GuEMM/ArduMagnetometer/README.md

## Project: Iniciación Científica - Departamento de Física
**Facultad de Ciencias Exactas y Naturales - Universidad Nacional de Asunción**

# ArduMagnetometer
This project contain the software for an arduino based low cost geomagnetometer using FG3 fluxgate sensors.
