GuEMM/ArduMagnetometer/Codigo_para_analisis_calibracion/Datos_corriente_FG3_s1_Curva1.csv

2 | 19692016 | 8727070 | -0.0815 | 0.00005 | Wed Jul 31 16:58:47 2019
3 | 19662588 | 8714294 | -0.0815 | 0.00005 | Wed Jul 31 16:58:48 2019
4 | 19663364 | 8714294 | -0.0815 | 0.00005 | Wed Jul 31 16:58:49 2019
5 | 19663364 | 8714142 | -0.0815 | 0.00005 | Wed Jul 31 16:58:50 2019
6 | 19662588 | 8714142 | -0.0815 | 0.00005 | Wed Jul 31 16:58:51 2019
7 | 19661044 | 8713990 | -0.0815 | 0.00005 | Wed Jul 31 16:58:52 2019
8 | 19663364 | 8714446 | -0.0815 | 0.00005 | Wed Jul 31 16:58:53 2019
9 | 19664136 | 8713990 | -0.0815 | 0.00005 | Wed Jul 31 16:58:54 2019
10 | 19662588 | 8713686 | -0.0815 | 0.00005 | Wed Jul 31 16:58:55 2019
11 | 19661044 | 8711864 | -0.0815 | 0.00005 | Wed Jul 31 16:58:56 2019
12 | 19661044 | 8711864 | -0.0815 | 0.00005 | Wed Jul 31 16:58:57 2019
13 | 19661044 | 8713382 | -0.0815 | 0.00005 | Wed Jul 31 16:58:58 2019
14 | 19659496 | 8713382 | -0.0815 | 0.00005 | Wed Jul 31 16:58:59 2019
15 | 19659496 | 8713078 | -0.0815 | 0.00005 | Wed Jul 31 16:59:00 2019
16 | 19659496 | 8713078 | -0.0815 | 0.00005 | Wed Jul 31 16:59:01 2019
17 | 19660270 | 8712320 | -0.0815 | 0.00005 | Wed Jul 31 16:59:02 2019
18 | 19659496 | 8712926 | -0.0815 | 0.00005 | Wed Jul 31 16:59:03 2019
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
