GuEMM/ArduMagnetometer/Codigo_para_analisis_calibracion/Datos_corriente_FG3_s2_Curva2.csv

234 | 18664376 | 8277597 | -0.0805 | 0.00005 | Tue Jul 30 13:27:02 2019
235 | 18664376 | 8277871 | -0.0805 | 0.00005 | Tue Jul 30 13:27:03 2019
236 | 18664376 | 8278008 | -0.0805 | 0.00005 | Tue Jul 30 13:27:04 2019
237 | 18662984 | 8277734 | -0.0805 | 0.00005 | Tue Jul 30 13:27:05 2019
238 | 18662984 | 8277460 | -0.0805 | 0.00005 | Tue Jul 30 13:27:06 2019
239 | 18664376 | 8277323 | -0.0805 | 0.00005 | Tue Jul 30 13:27:07 2019
240 | 18664376 | 8276364 | -0.0805 | 0.00005 | Tue Jul 30 13:27:08 2019
241 | 18665072 | 8276227 | -0.0805 | 0.00005 | Tue Jul 30 13:27:09 2019
242 | 18665072 | 8276227 | -0.0805 | 0.00005 | Tue Jul 30 13:27:10 2019
243 | 18665072 | 8276227 | -0.0805 | 0.00005 | Tue Jul 30 13:27:11 2019
244 | 18663680 | 8276227 | -0.0805 | 0.00005 | Tue Jul 30 13:27:12 2019
245 | 18663680 | 8276638 | -0.0805 | 0.00005 | Tue Jul 30 13:27:13 2019
246 | 18663680 | 8276775 | -0.0805 | 0.00005 | Tue Jul 30 13:27:14 2019
247 | 18663680 | 8277049 | -0.0805 | 0.00005 | Tue Jul 30 13:27:15 2019
248 | 18663680 | 8277049 | -0.0805 | 0.00005 | Tue Jul 30 13:27:16 2019
249 | 18663680 | 8277186 | -0.0805 | 0.00005 | Tue Jul 30 13:27:17 2019
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
