GuEMM/ArduMagnetometer/Codigo_para_analisis_calibracion/Datos_corriente_FG3_s2_Curva3.csv

3 | 18991908 | 8253140 | -0.0796 | 0.00005 | Wed Jul 31 12:56:58 2019
4 | 18989024 | 8252731 | -0.0796 | 0.00005 | Wed Jul 31 12:56:59 2019
5 | 18989744 | 8252459 | -0.0796 | 0.00005 | Wed Jul 31 12:57:00 2019
6 | 18989744 | 8252323 | -0.0796 | 0.00005 | Wed Jul 31 12:57:01 2019
7 | 18988304 | 8252595 | -0.0796 | 0.00005 | Wed Jul 31 12:57:02 2019
8 | 18989744 | 8252595 | -0.0796 | 0.00005 | Wed Jul 31 12:57:03 2019
9 | 18990466 | 8253004 | -0.0796 | 0.00005 | Wed Jul 31 12:57:04 2019
10 | 18991188 | 8252867 | -0.0796 | 0.00005 | Wed Jul 31 12:57:05 2019
11 | 18987582 | 8251642 | -0.0796 | 0.00005 | Wed Jul 31 12:57:06 2019
12 | 18986860 | 8250825 | -0.0796 | 0.00005 | Wed Jul 31 12:57:07 2019
13 | 18986140 | 8250280 | -0.0796 | 0.00005 | Wed Jul 31 12:57:08 2019
14 | 18985420 | 8250280 | -0.0796 | 0.00005 | Wed Jul 31 12:57:09 2019
15 | 18983976 | 8250008 | -0.0796 | 0.00005 | Wed Jul 31 12:57:10 2019
16 | 18983976 | 8251097 | -0.0796 | 0.00005 | Wed Jul 31 12:57:11 2019
17 | 18983976 | 8251914 | -0.0796 | 0.00005 | Wed Jul 31 12:57:12 2019
18 | 18986140 | 8251369 | -0.0796 | 0.00005 | Wed Jul 31 12:57:13 2019
19 | 18984698 | 8251914 | -0.0796 | 0.00005 | Wed Jul 31 12:57:14 2019
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
