GuEMM/ArduMagnetometer/Codigo_para_analisis_calibracion/Datos_corriente_FG3_s4_Curva1.csv

2 | 18574932 | 26406126 | 0.0808 | 0.00005 | Fri Aug 2 14:32:01 2019
3 | 18555628 | 26379656 | 0.0808 | 0.00005 | Fri Aug 2 14:32:02 2019
4 | 18556318 | 26379656 | 0.0808 | 0.00005 | Fri Aug 2 14:32:03 2019
5 | 18555628 | 26379656 | 0.0808 | 0.00005 | Fri Aug 2 14:32:04 2019
6 | 18556318 | 26381048 | 0.0808 | 0.00005 | Fri Aug 2 14:32:05 2019
7 | 18555628 | 26379656 | 0.0808 | 0.00005 | Fri Aug 2 14:32:06 2019
8 | 18556318 | 26381048 | 0.0808 | 0.00005 | Fri Aug 2 14:32:07 2019
9 | 18555628 | 26381048 | 0.0808 | 0.00005 | Fri Aug 2 14:32:08 2019
10 | 18556318 | 26382440 | 0.0808 | 0.00005 | Fri Aug 2 14:32:09 2019
11 | 18554252 | 26382440 | 0.0808 | 0.00005 | Fri Aug 2 14:32:10 2019
12 | 18554940 | 26382440 | 0.0808 | 0.00005 | Fri Aug 2 14:32:11 2019
13 | 18554940 | 26383832 | 0.0808 | 0.00005 | Fri Aug 2 14:32:12 2019
14 | 18554940 | 26383832 | 0.0808 | 0.00005 | Fri Aug 2 14:32:13 2019
15 | 18554252 | 26382440 | 0.0808 | 0.00005 | Fri Aug 2 14:32:14 2019
16 | 18554940 | 26383832 | 0.0808 | 0.00005 | Fri Aug 2 14:32:15 2019
17 | 18554252 | 26383832 | 0.0808 | 0.00005 | Fri Aug 2 14:32:16 2019
18 | 18554940 | 26386616 | 0.0808 | 0.00005 | Fri Aug 2 14:32:17 2019
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
