GuEMM/ArduMagnetometer/Campo Helicoidal simulado para calibracion del sensor/Campo_interno_modelo.png

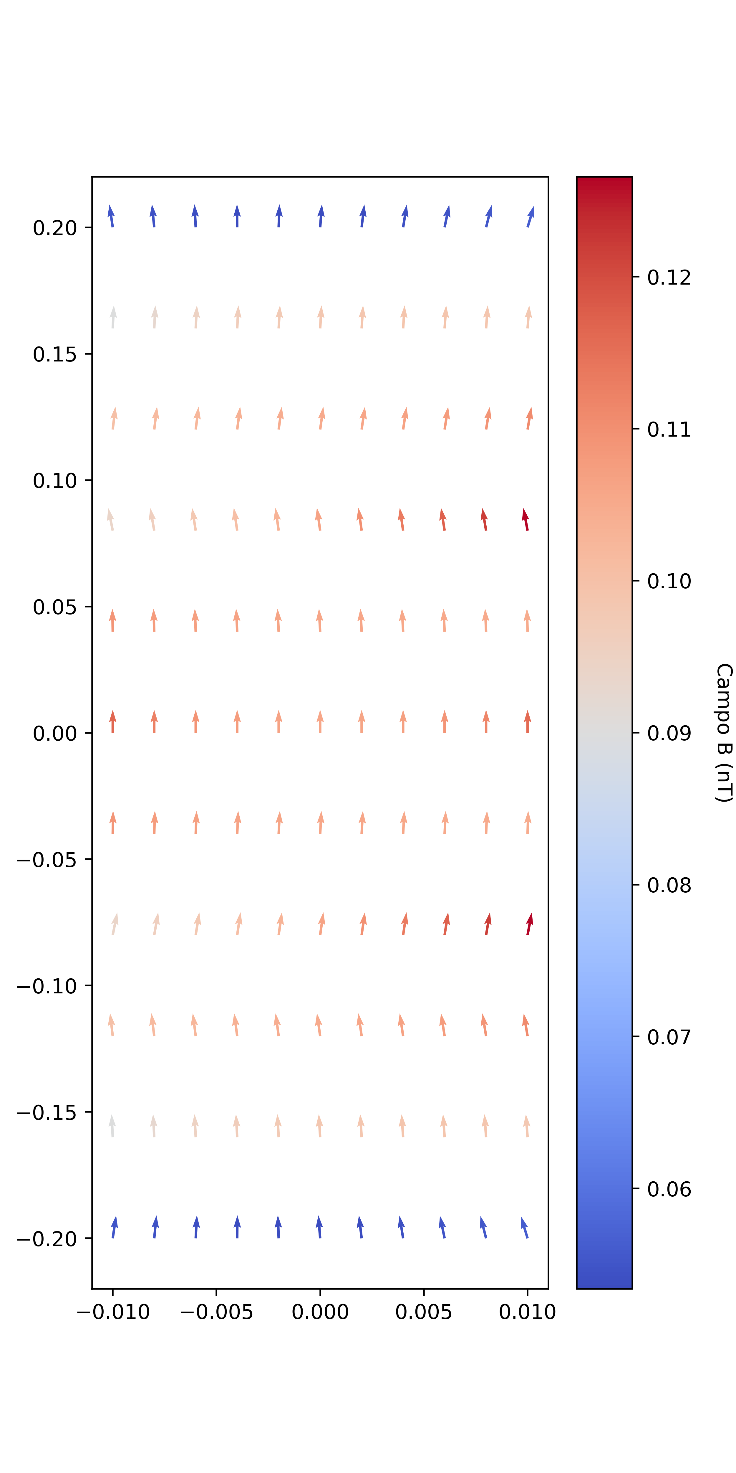
Campo Helicoidal simulado para calibracion del sensor/Campo_interno_modelo.png
