GuEMM/ArduMagnetometer/Codigo_para_analisis_calibracion/resultados_ajuste_ruido_sin_blindaje.png

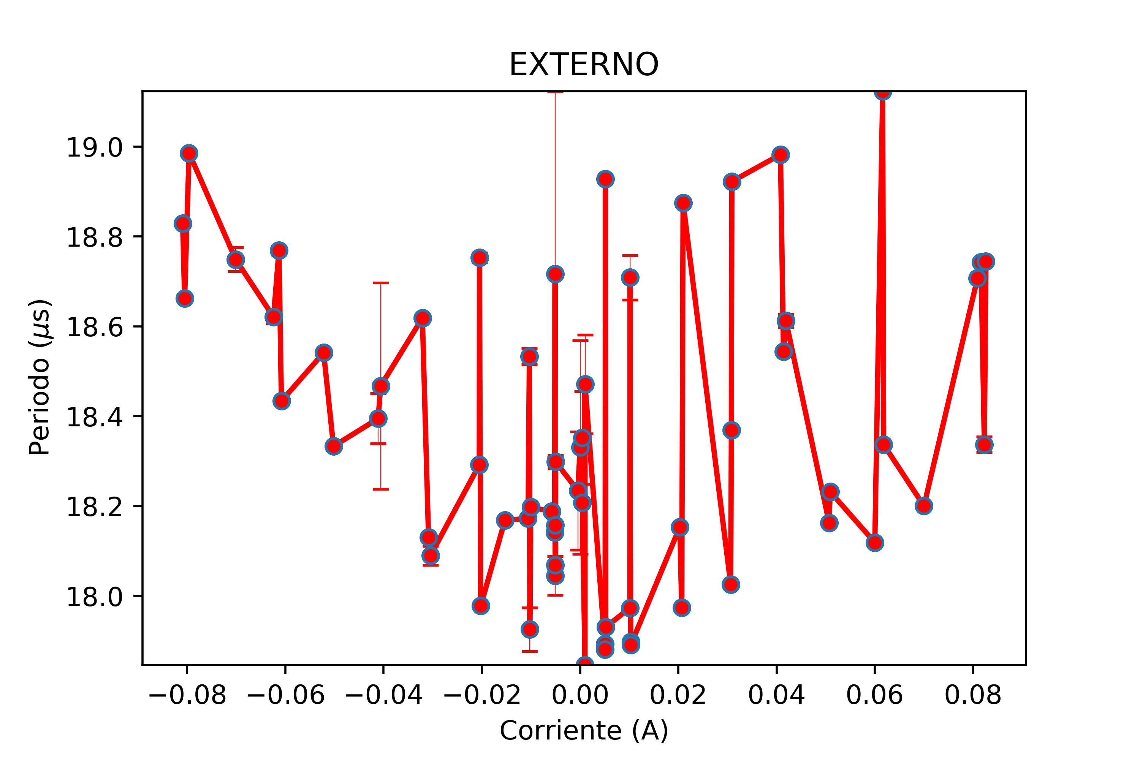
Codigo_para_analisis_calibracion/resultados_ajuste_ruido_sin_blindaje.png
