GuEMM/ArduMagnetometer/Codigo_para_analisis_calibracion/resultados_calibracion_FG1.png

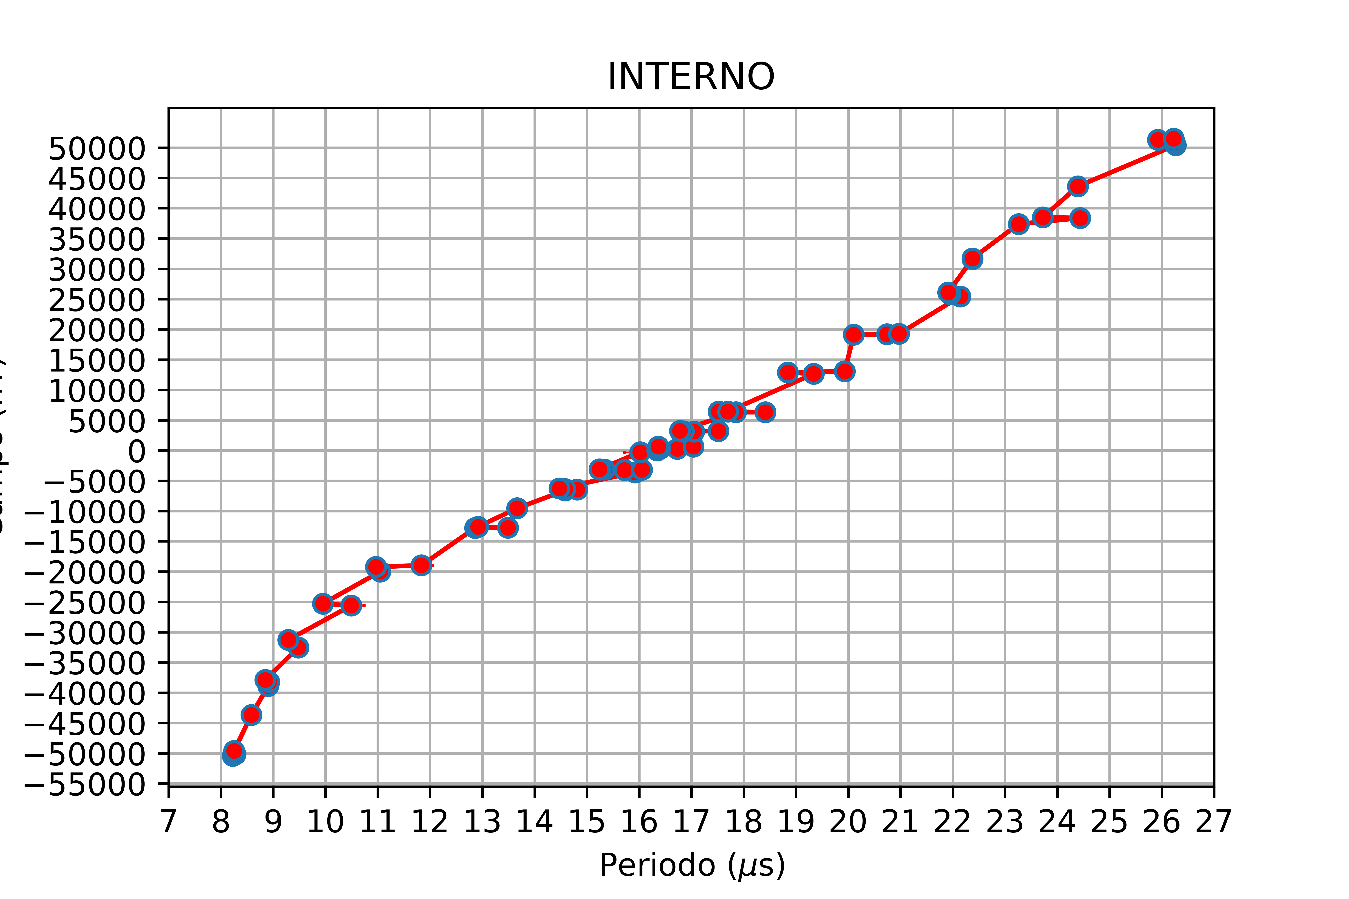
Codigo_para_analisis_calibracion/resultados_calibracion_FG1.png
