GuEMM/ArduMagnetometer/Codigo_para_analisis_calibracion/resultados_curvas_calibracion_Sensor_2.png

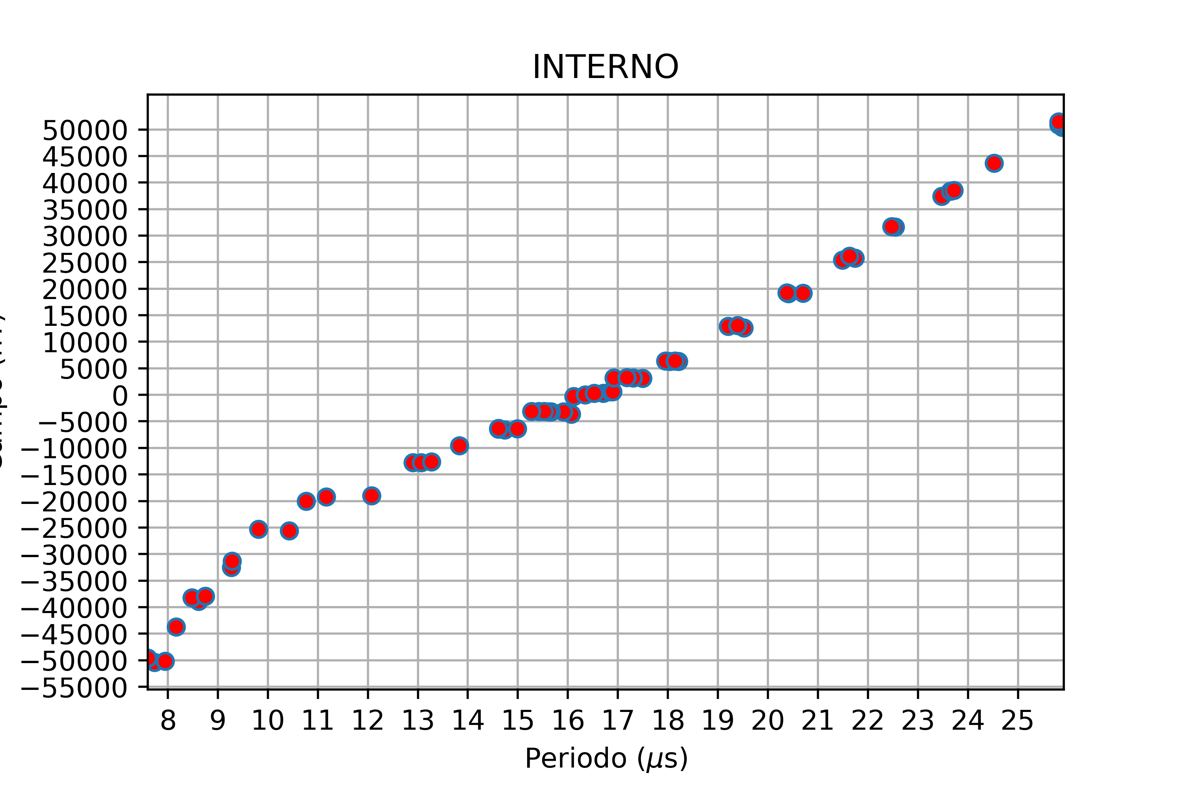
Codigo_para_analisis_calibracion/resultados_curvas_calibracion_Sensor_2.png
