GuEMM/ArduMagnetometer/Conversion_periodo_a_campo/grafico_fuente_pc_prueba_sin_blindaje.png

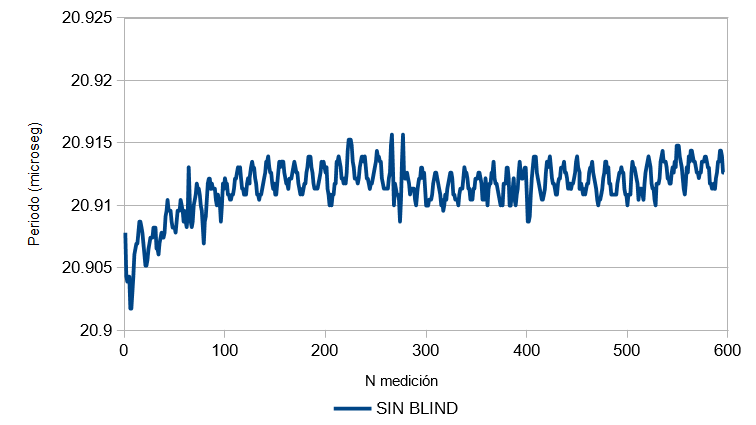
Conversion_periodo_a_campo/grafico_fuente_pc_prueba_sin_blindaje.png
