GuEMM/ArduMagnetometer/Conversion_periodo_a_campo/grafico_primera_prueba.png

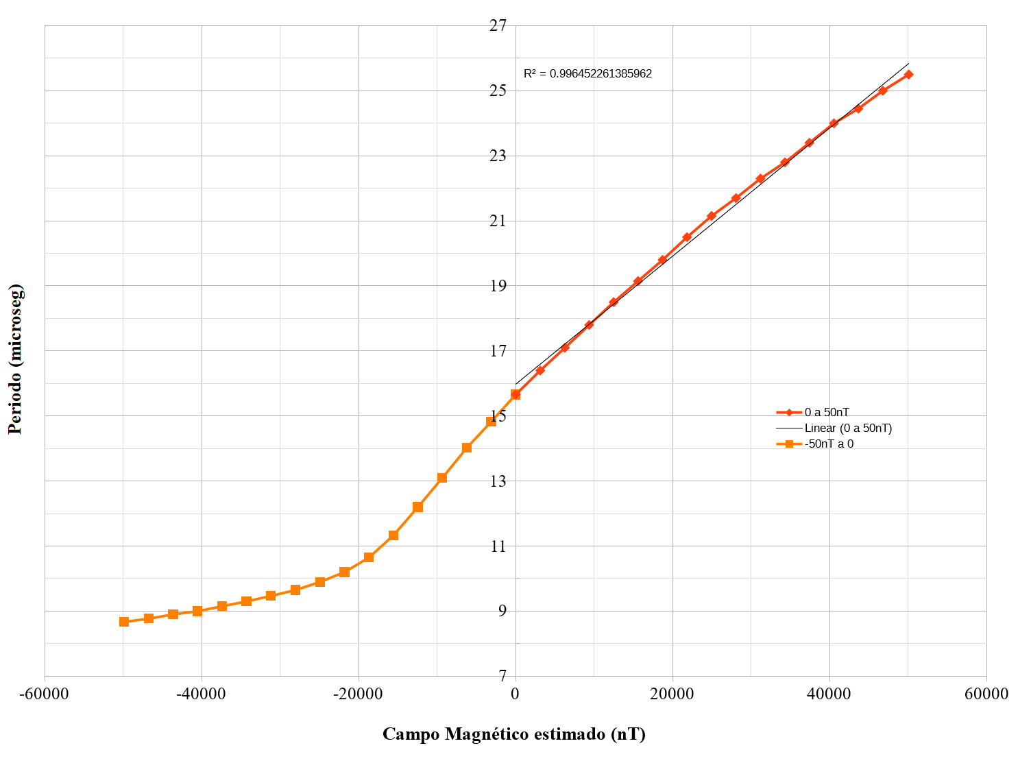
Conversion_periodo_a_campo/grafico_primera_prueba.png
