GuEMM/ArduMagnetometer/Conversion_periodo_a_campo/grafico_prueba_fuente_blindaje.png

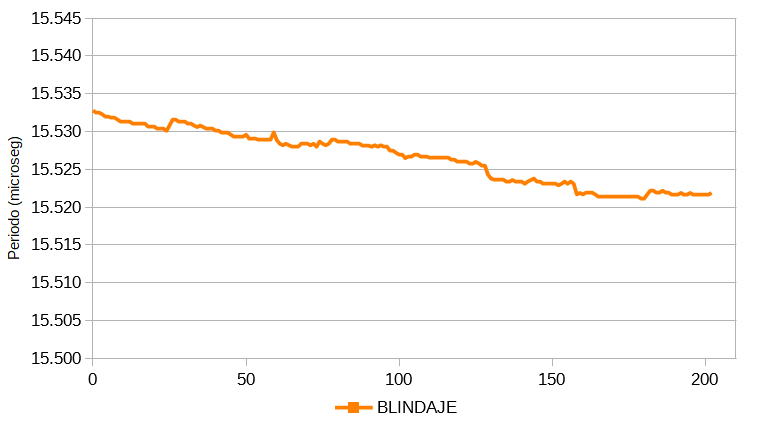
Conversion_periodo_a_campo/grafico_prueba_fuente_blindaje.png
