GuEMM/ArduMagnetometer/Curvas_calibracion/Comparacion_datos.png

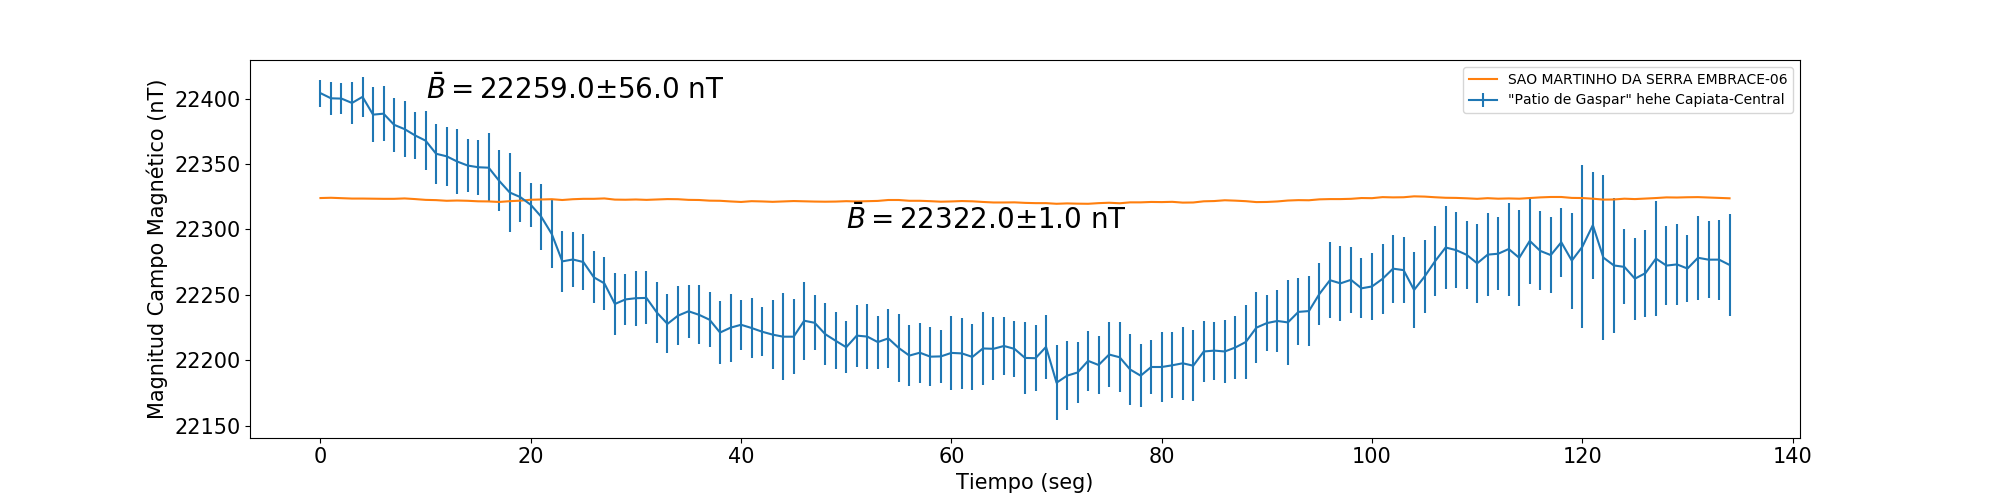
Curvas_calibracion/Comparacion_datos.png
