GuEMM/ArduMagnetometer/Curvas_calibracion/Curva_sensor_1_curva_2.png

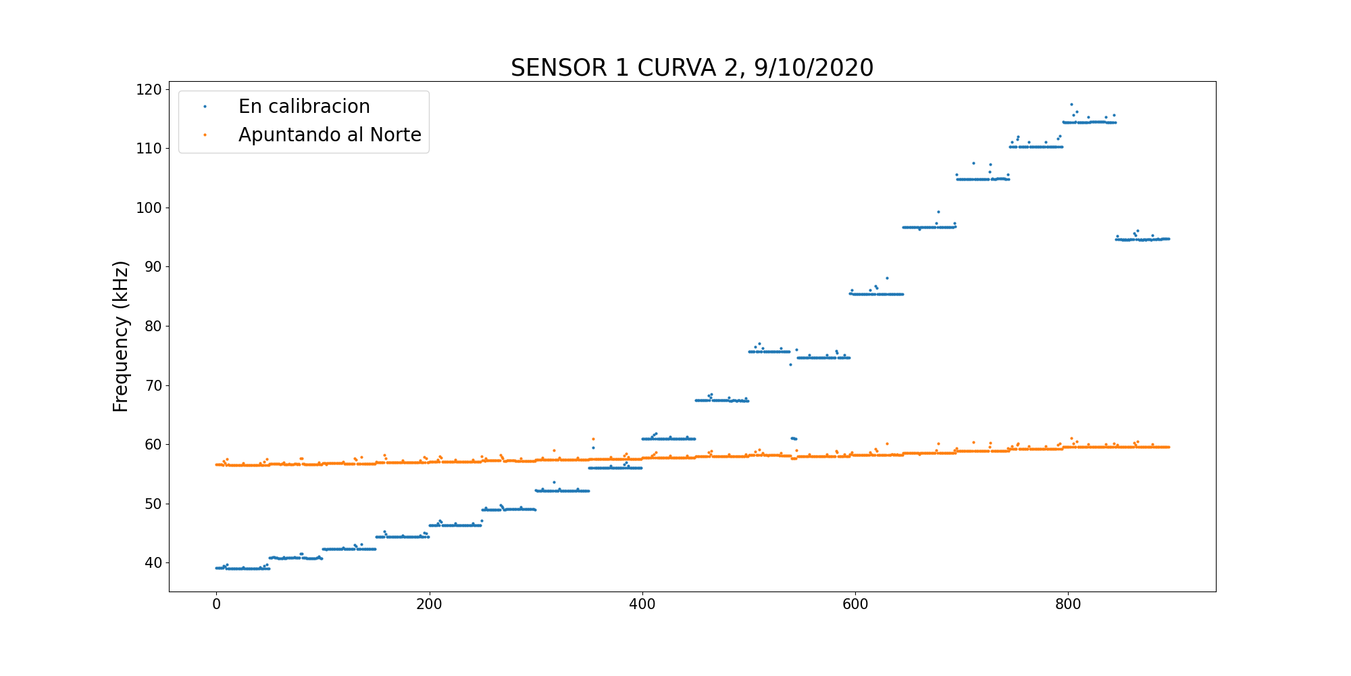
Curvas_calibracion/Curva_sensor_1_curva_2.png
