GuEMM/ArduMagnetometer/Curvas_calibracion/Curva_sensor_1_curva_3.png

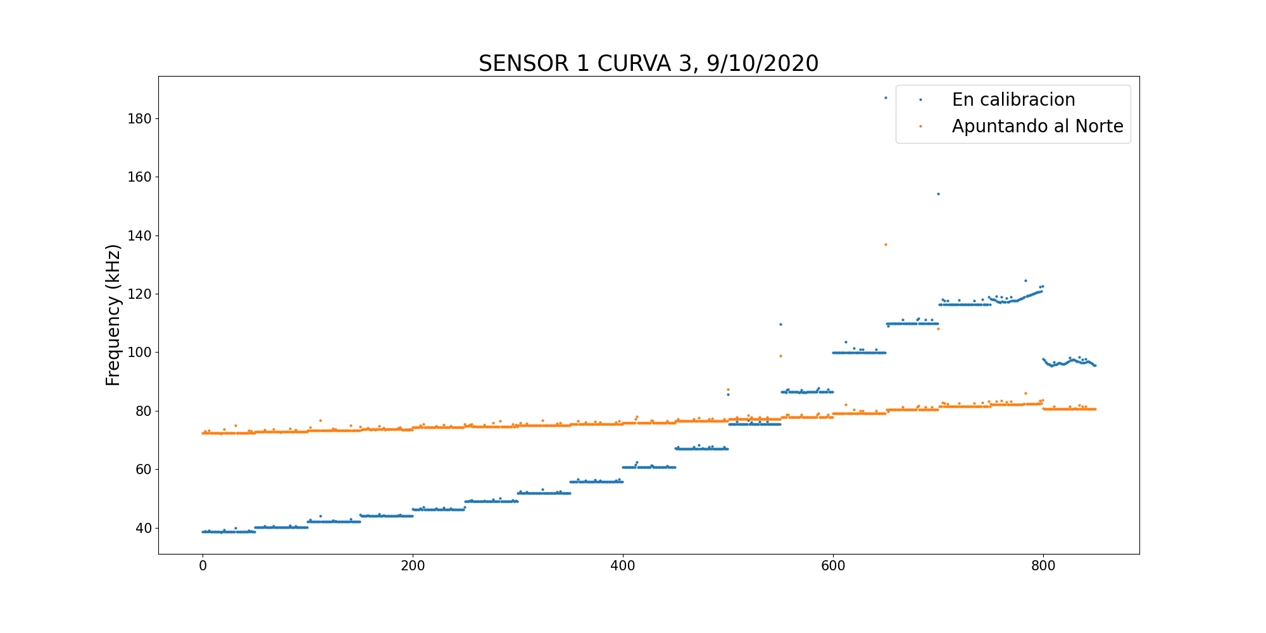
Curvas_calibracion/Curva_sensor_1_curva_3.png
