GuEMM/ArduMagnetometer/Curvas_calibracion/CURVAS_9_10_2020.png

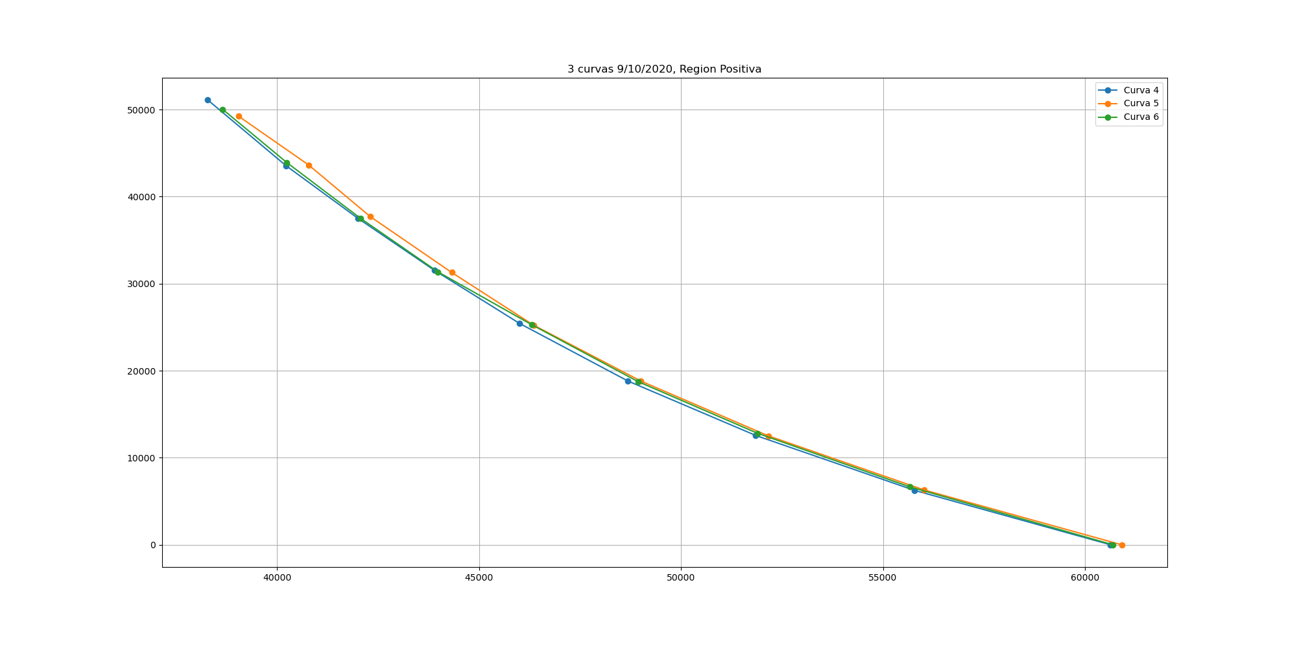
Curvas_calibracion/CURVAS_9_10_2020.png
