GuEMM/ArduMagnetometer/Curvas_calibracion/CURVAS_AJUSTADAS_VARIAS_MEDICIONES.png

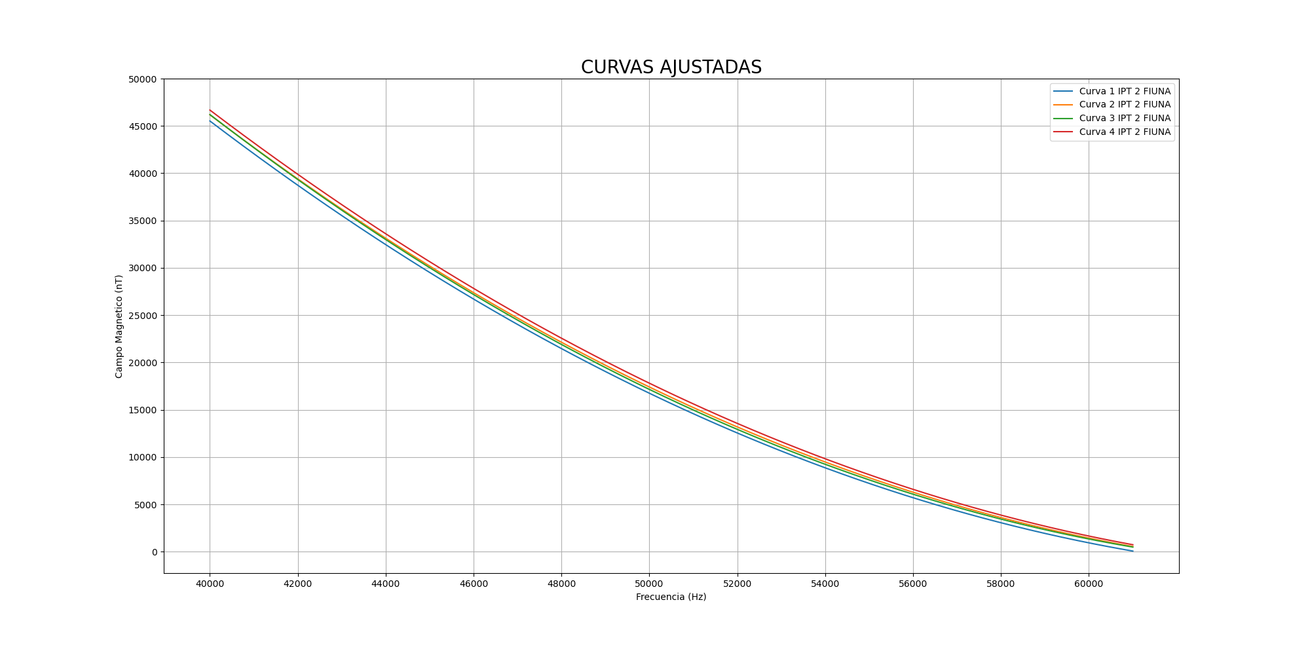
Curvas_calibracion/CURVAS_AJUSTADAS_VARIAS_MEDICIONES.png
