GuEMM/ArduMagnetometer/Curvas_calibracion/CURVAS_COMPARACION.png

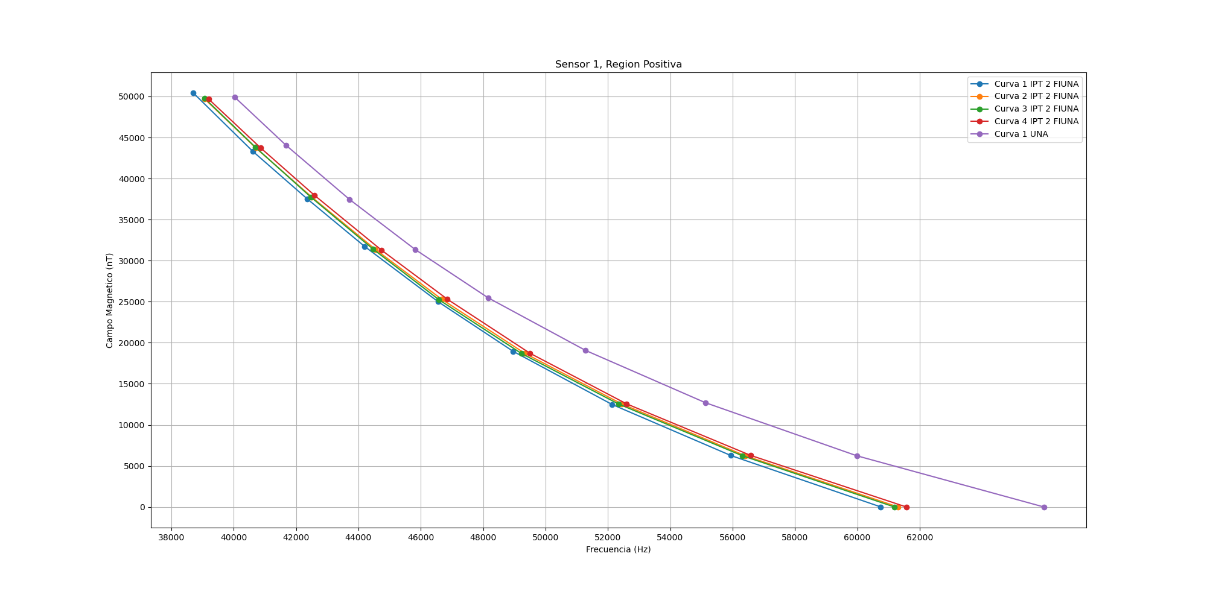
Curvas_calibracion/CURVAS_COMPARACION.png
