GuEMM/ArduMagnetometer/Curvas_calibracion/Datos_4_horas.png

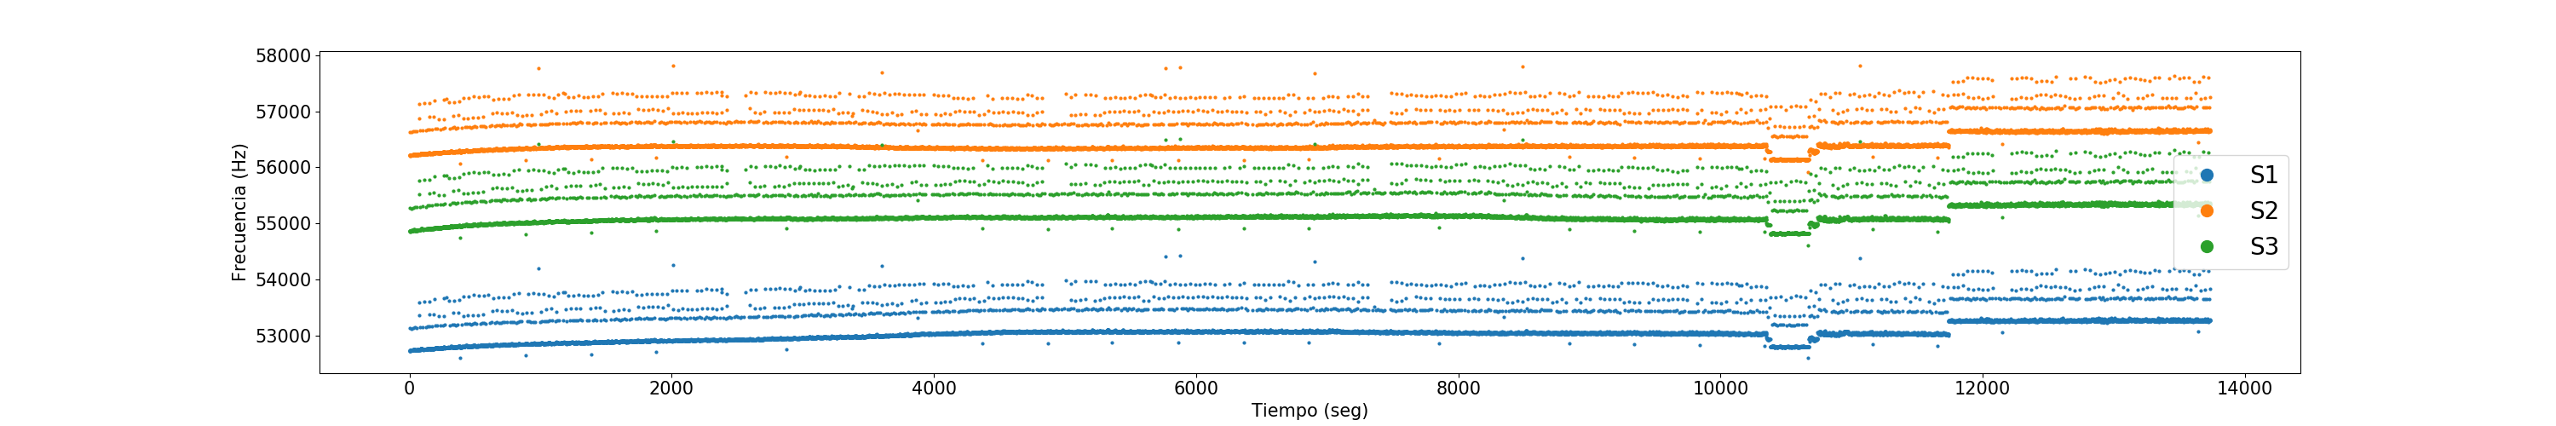
Curvas_calibracion/Datos_4_horas.png
