GuEMM/ArduMagnetometer/Curvas_calibracion/Datos_Campo_filtrado.png

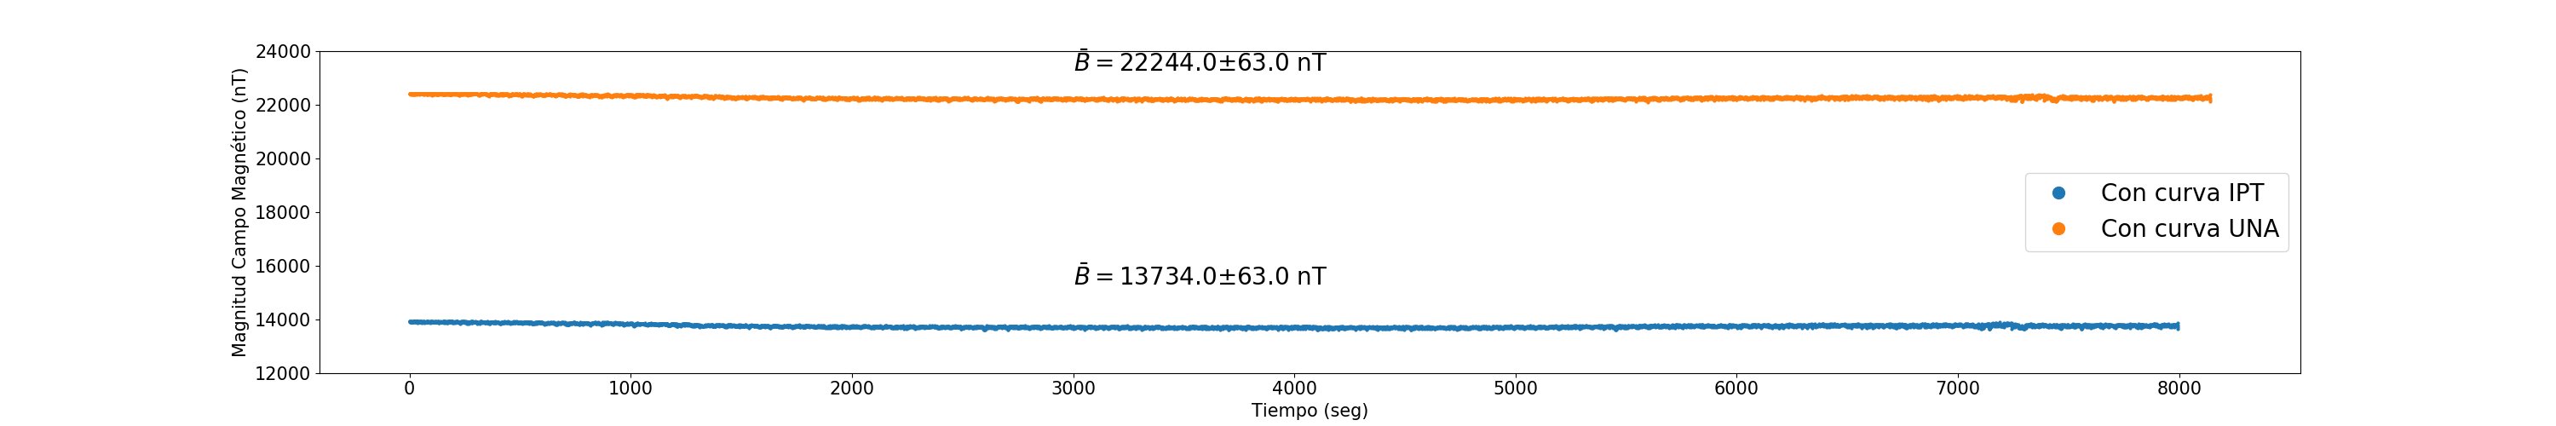
Curvas_calibracion/Datos_Campo_filtrado.png
