GuEMM/ArduMagnetometer/Curvas_calibracion/Datos_Campo_filtrado_UNA.png

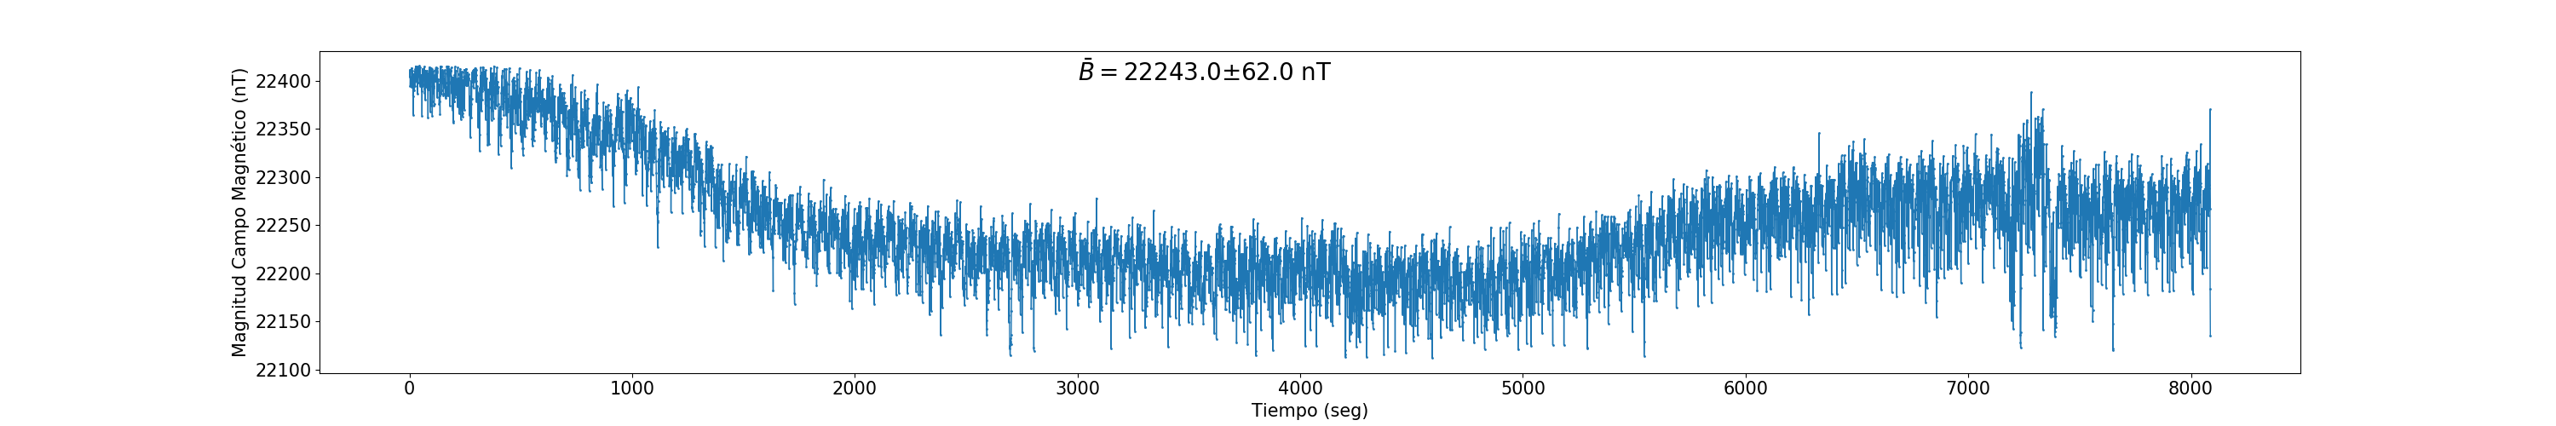
Curvas_calibracion/Datos_Campo_filtrado_UNA.png
