GuEMM/ArduMagnetometer/Curvas_calibracion/Datos_Campo_Horizontal.png

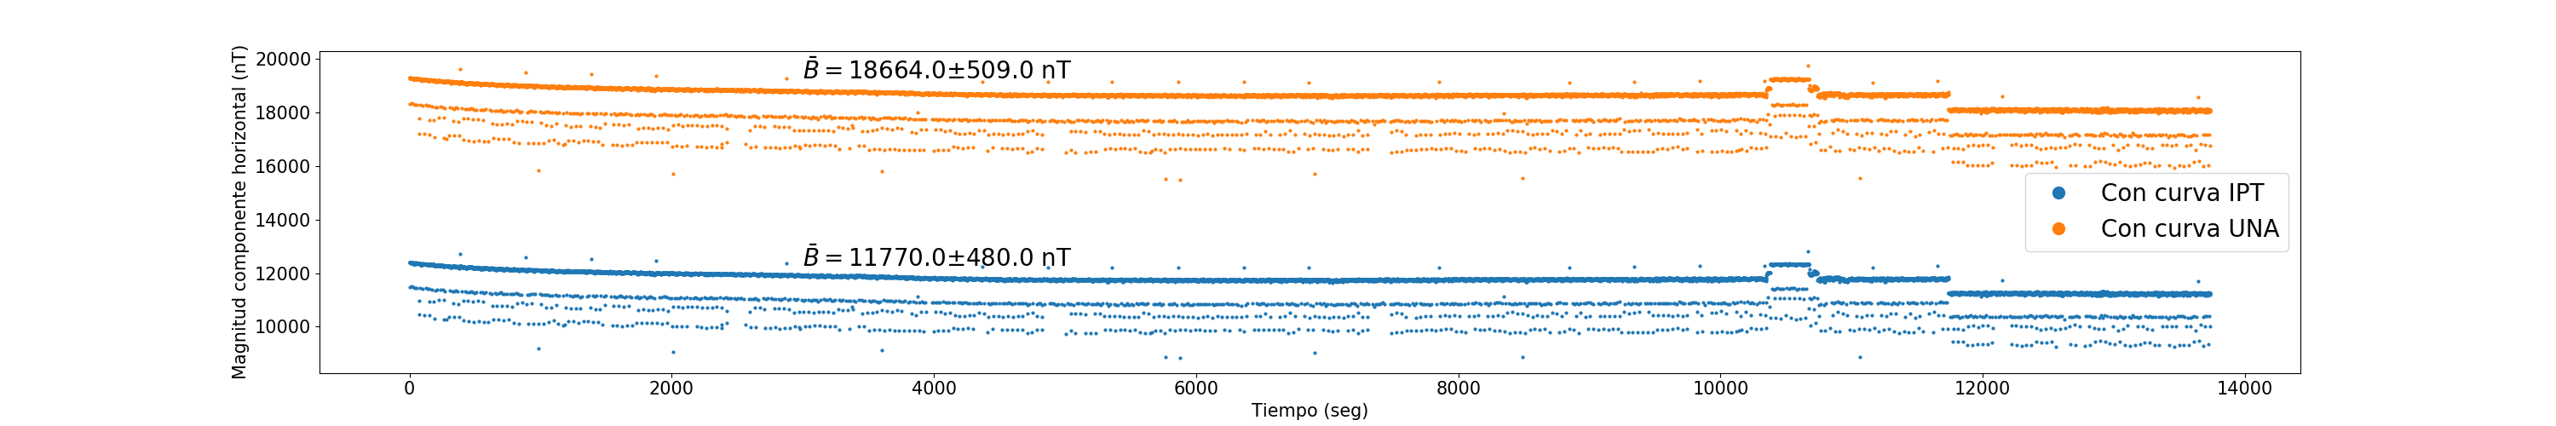
Curvas_calibracion/Datos_Campo_Horizontal.png
