GuEMM/ArduMagnetometer/Curvas_calibracion/Diferencia_entre_curvas.png

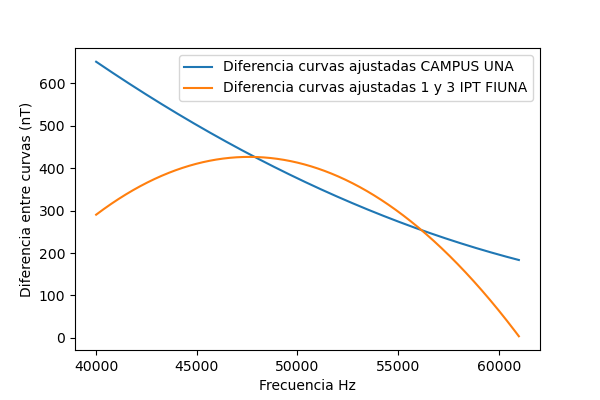
Curvas_calibracion/Diferencia_entre_curvas.png
