GuEMM/ArduMagnetometer/Curvas_calibracion/Diferencia_entre_curvas_ajustadas.png

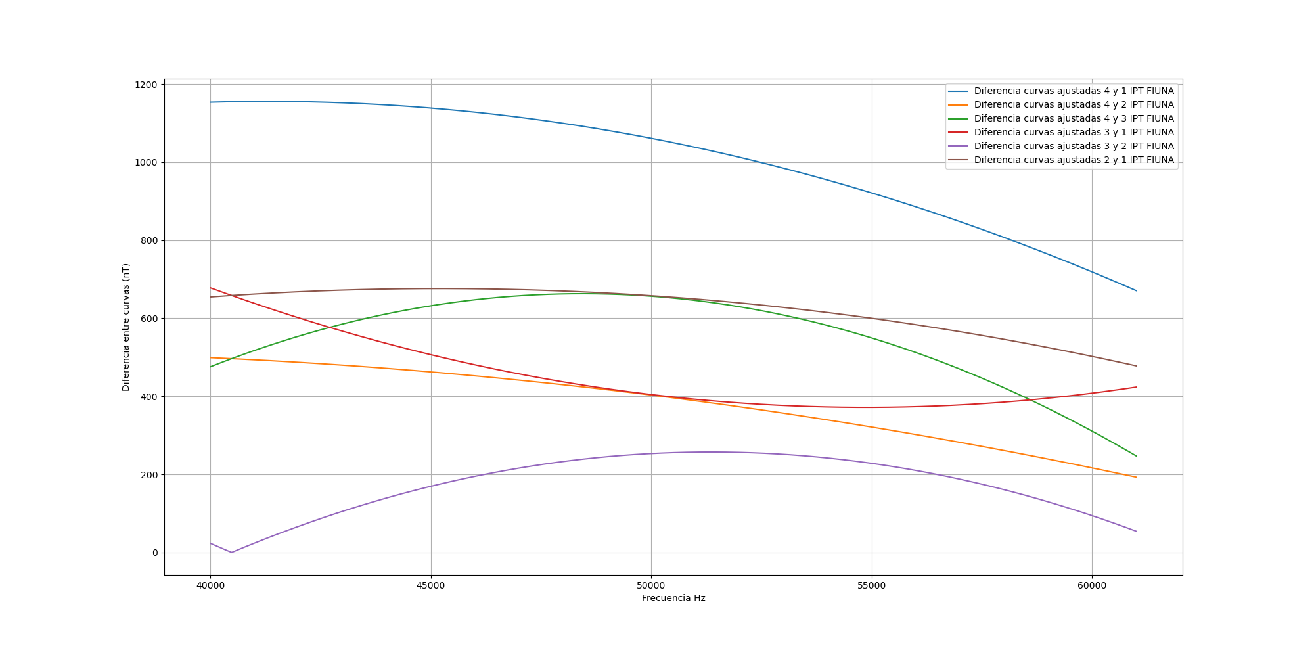
Curvas_calibracion/Diferencia_entre_curvas_ajustadas.png
