GuEMM/ArduMagnetometer/Curvas_calibracion/resultados_calibracion_FG1.png

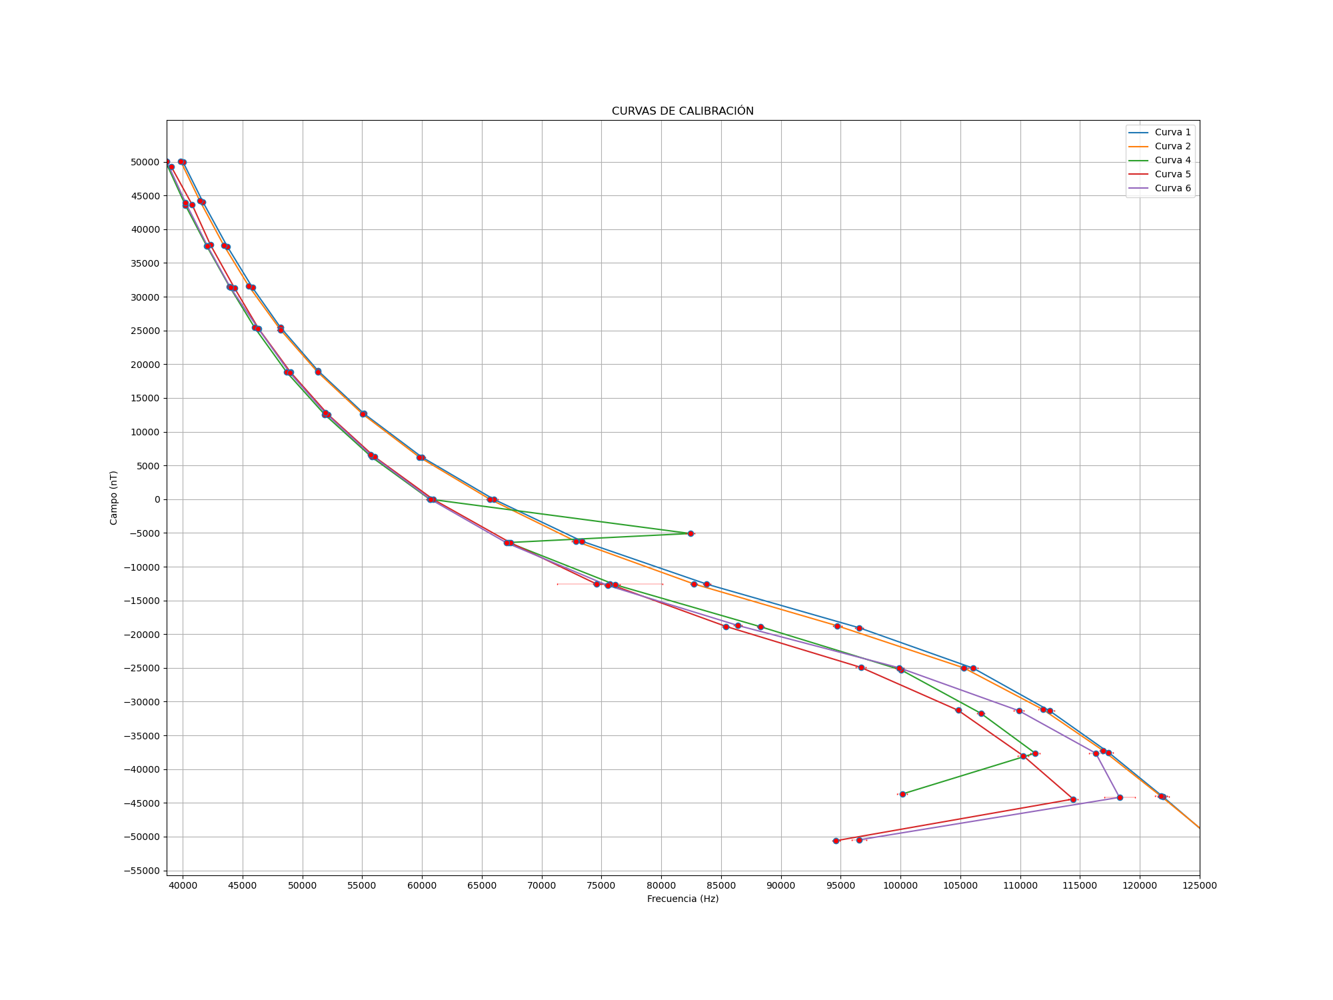
Curvas_calibracion/resultados_calibracion_FG1.png
