GuEMM/ArduMagnetometer/Curvas_calibracion/Resultados_calibracion_IPT2.png

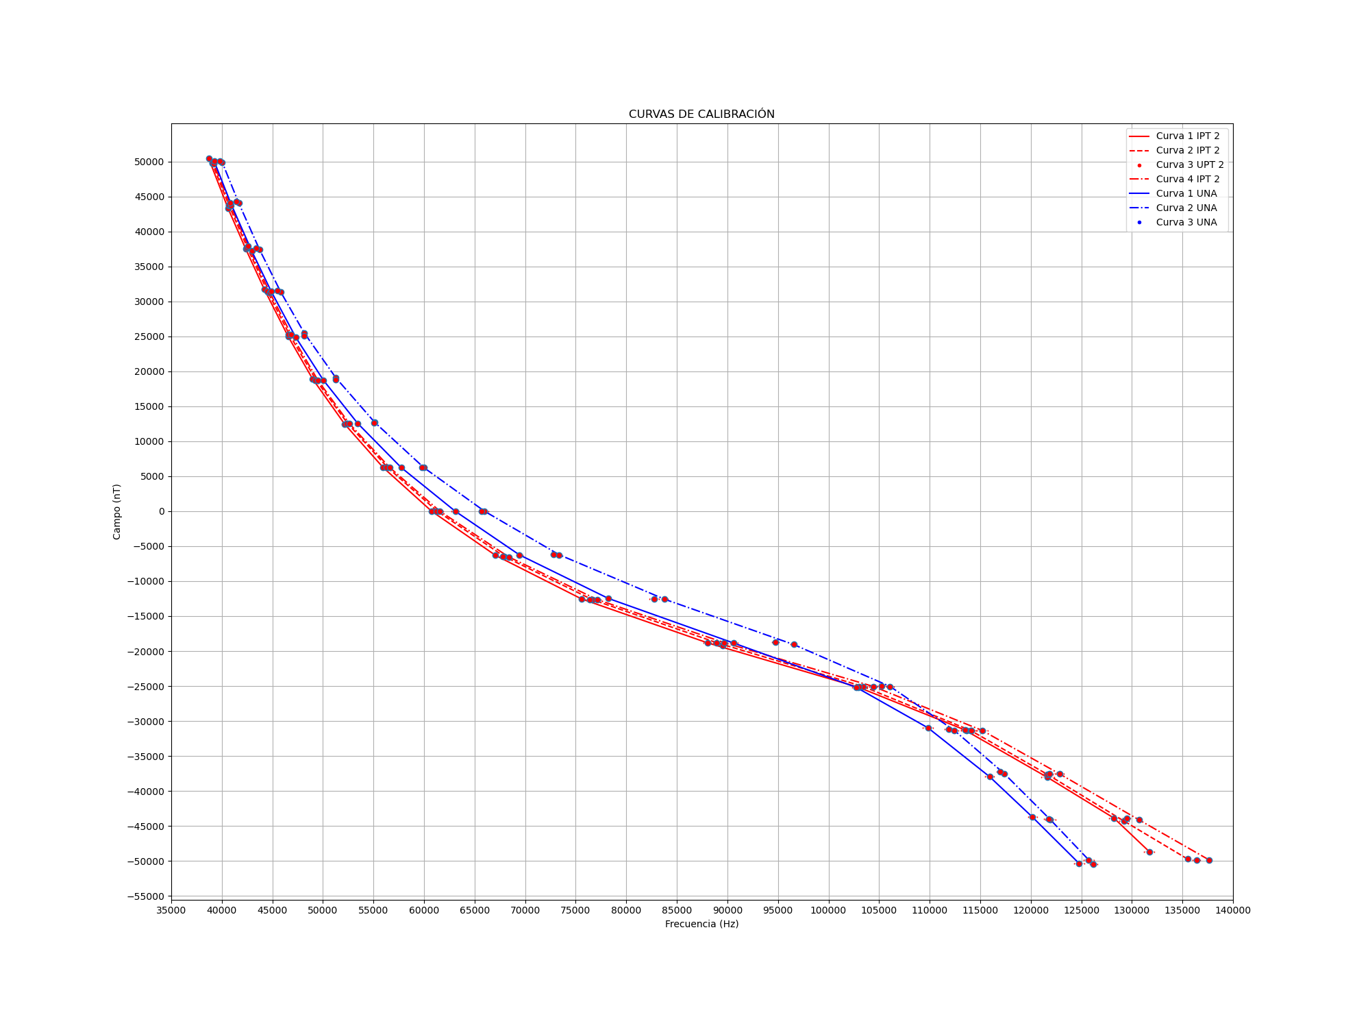
Curvas_calibracion/Resultados_calibracion_IPT2.png
