GuEMM/ArduMagnetometer/Schematic_Magnetometer_FG3_sensor_2020-07-25_13-28-01.pdf

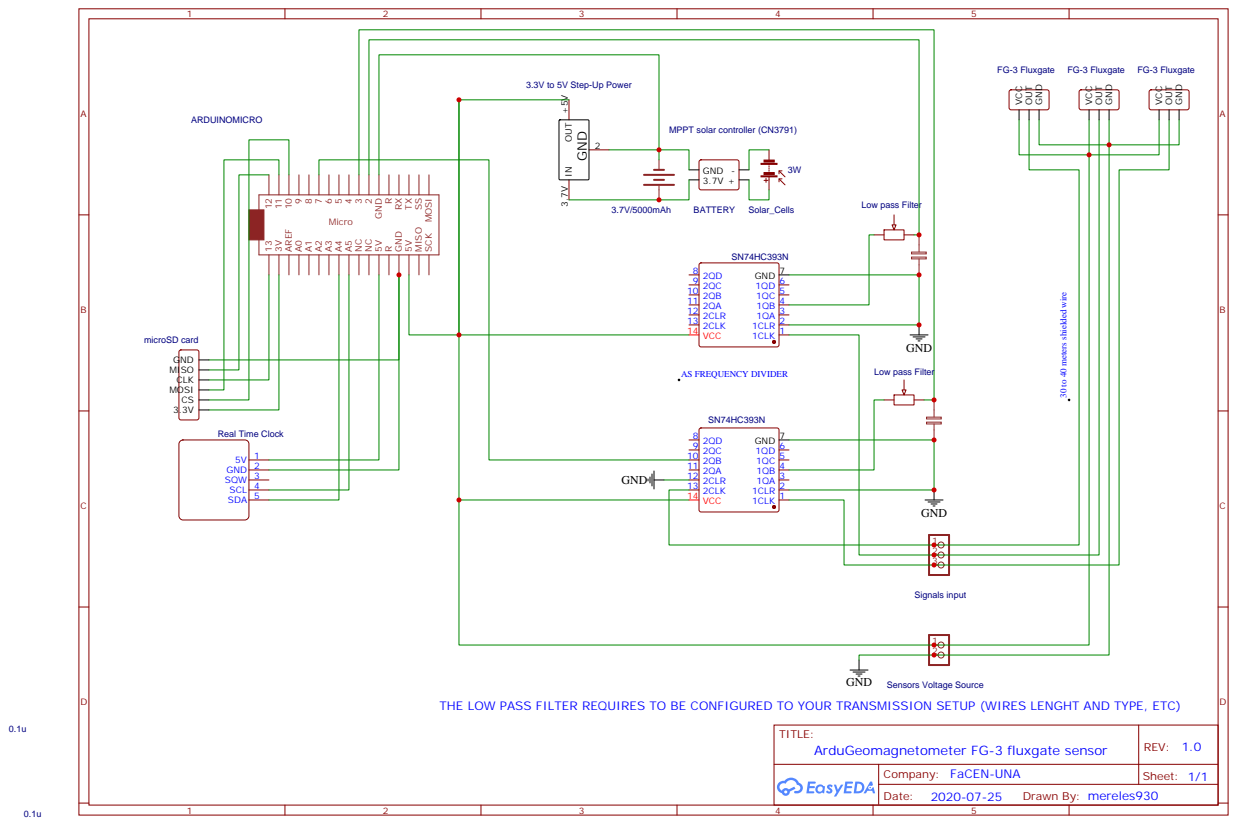
[picture p42: page 1]

FG-3 Fluxgate VCC OUT GND

3.3V to 5V Step-Up Power OUT +⁵V

30 to 40 meters shielded wire

THE LOW PASS FILTER REQUIRES TO BE CONFIGURED TO YOUR TRANSMISSION SETUP (WIRES LENGHT AND TYPE, ETC)
