GuEMM/ArduMagnetometer/Conversion_periodo_a_campo/Modulo_medio_min.pdf

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

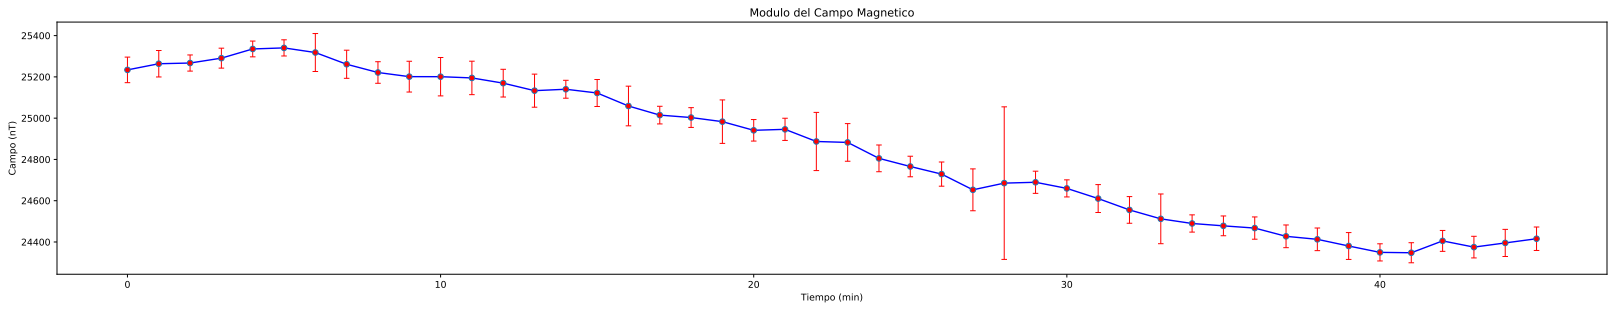
[picture p46: page 1]
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
