GuEMM/ArduMagnetometer/Conversion_periodo_a_campo/Registro_comp_vete_seg.pdf

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

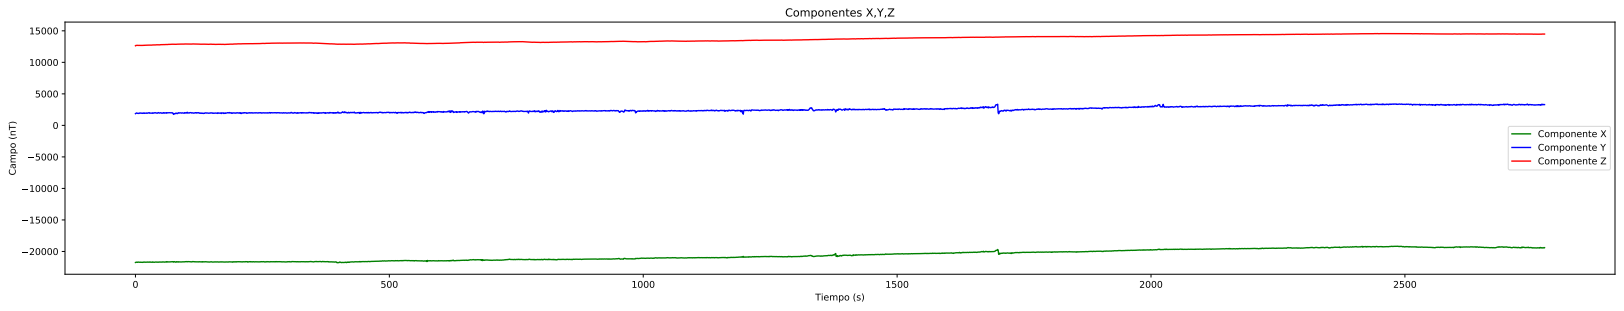
[picture p47: page 1]
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
