GuEMM/ArduMagnetometer/Conversion_periodo_a_campo/Registro_mod_vete_seg.pdf

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

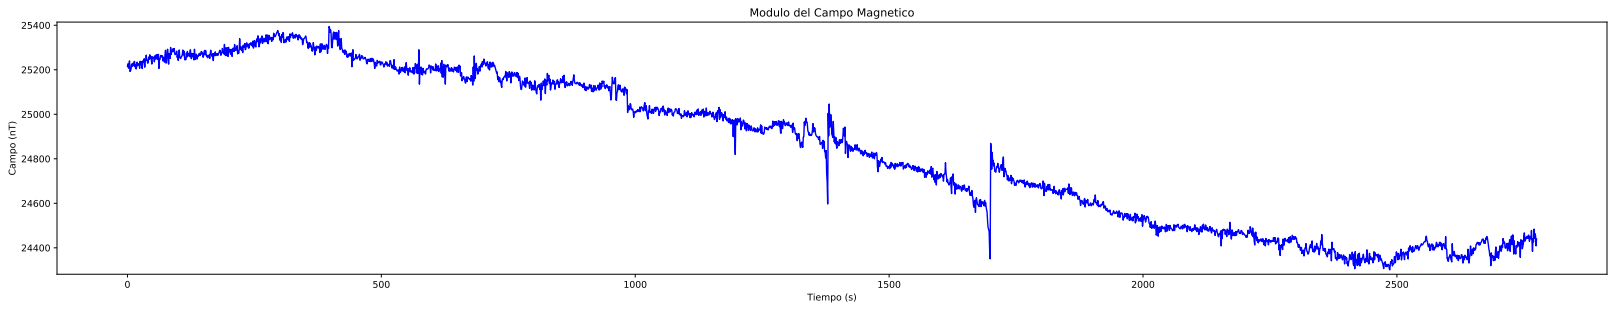
[picture p49: page 1]
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
